EVtivity/evtivity-ev-tester/jlcpcb/ac-tester-bom.csv

Comment | Designator | Footprint | LCSC Part #
2N7002 | Q1,Q2,Q5,Q6,Q7 | SOT-23 | C8545
SMAJ6.0A (6.0V standoff clears the 5.25V rail) | TVS1 | SMA | C10683
silicon signal diode (J1772 CP series) | D1 | SOD-323 | C2128
BAT54WS | D2,D3 | SOD-323 | C22629
TPS26621 60V eFuse OVP+auto-retry | U3 | VSON-10(DRC) | C1848341
390k 1% | R11 | 0603 | C137735
51k 1% | R12 | 0603 | C23196
110k 1% | R13 | 0603 | C25805
10k 1% | R14,R16,R17,R18,R19 | 0603 | C98220
100k 1% | R20,R15,R2,R4,R21 | 0603 | C25803
1uF X7R 50V | C8 | 0603 | C559769
15V bidir TVS | TVS2 | SOD-323 | C720654
PP ESD 3V3 | D6 | SOD-323 | C2687129
PMEG2005AEA very-low-VF 20V Schottky (LCD-5V OR) | D7,D8 | SOD-323 | C179428
2.74k 1% | R1 | 0603 | C22944
1.3k 1% | R3 | 0603 | C22767
220 1% | R10 | 0603 | C22962
33k 1% | R7 | 0603 | C4216
330 1% | R8 | 0603 | C23138
1k 1% | R9 | 0603 | C21190
1nF C0G 50V | C1,C2 | 0603 | C163508
100nF 50V | C4,C6,C7 | 0603 | C14663
10uF 25V | C5,C3 | 0603 | C96446
PTC resettable 1A | F1 | 1812 | C142747
AP2112K-3.3 600mA LDO | U2 | SOT-23-5 | C51118
