EVtivity/evtivity-ev-tester/jlcpcb/ac-tester-3d-full.step

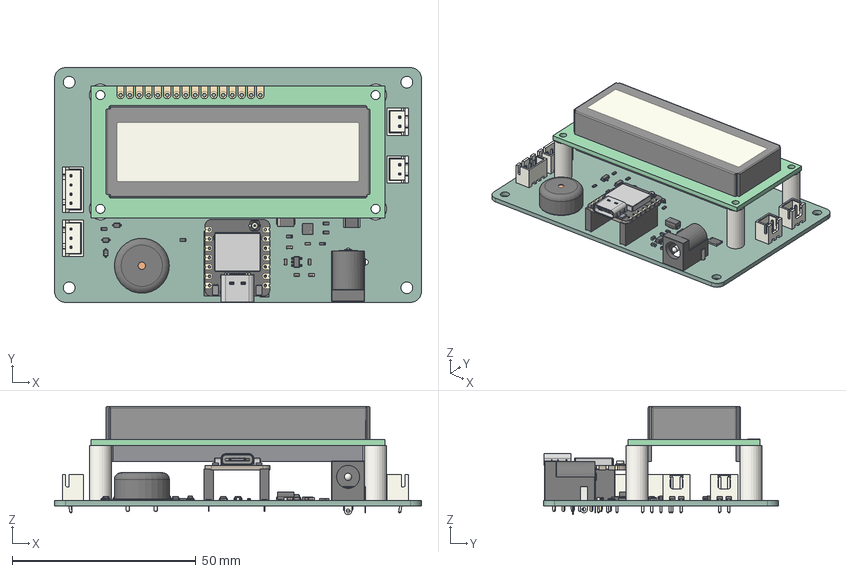
[picture p7: CAD file, 2026-09-27]
jlcpcb/ac-tester-3d-full.step
100.0 x 64.0 x 29.5 mm
JST_B4B_XH_A
VSON_10_1EP_3x3mm_Pitch05mm_ThermalPad
R_0603_1608Metric x 19
PinSocket_1x07_P2.54mm_Vertical x 2
JST_B3B_XH_A
SOT-23 x 5
D_SOD-323 x 7
Pad_001_sp
SOT-23-5
JST_B2B_XH_A x 2
Mounting_Wuerth_WA-SMSI-M3_H15mm_9774150360 x 4
C_0603_1608Metric x 8
Buzzer_15x75RM76
BarrelJack_Horizontal
D_SMA
R_1812_4532Metric
BOSS-EXTRUDE14_8_
BOSS-EXTRUDE7_4_
BOSS-EXTRUDE7_3_
BOSS-EXTRUDE14_4_
BOSS-EXTRUDE14_2_
BOSS-EXTRUDE14_11_
BOSS-EXTRUDE7_7_
BOSS-EXTRUDE14_9_
BOSS-EXTRUDE14_3_
BOSS-EXTRUDE14_7_
MIRROR2
BOSS-EXTRUDE14_5_
BOSS-EXTRUDE14_12_
BOSS-EXTRUDE7_8_
BOSS-EXTRUDE7_1_
BOSS-EXTRUDE14_10_
BOSS-EXTRUDE7_9_
BOSS-EXTRUDE14_6_
BOSS-EXTRUDE14_1_
BOSS-EXTRUDE7_6_
BOSS-EXTRUDE7_2_
CUT-EXTRUDE5
BOSS-EXTRUDE7_5_
Shield
Pins x 2
U.FL-R-SMT-1_10_ v1
ac-tester-step_PCB
