EVtivity/evtivity-ev-tester/enclosure/EV-Tester-case-bottom.stl

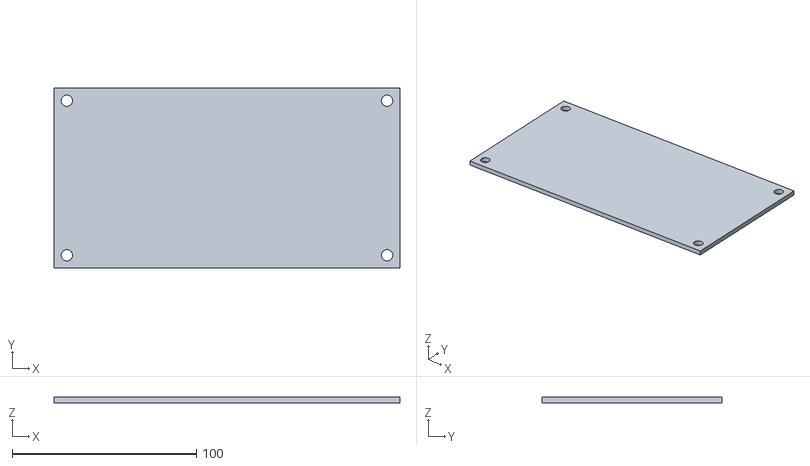
[picture p8: CAD file, 2026-09-27]
enclosure/EV-Tester-case-bottom.stl
188.0 x 98.0 x 3.00
