EVtivity/evtivity-ev-tester/enclosure/EV-Tester-case-top.stl

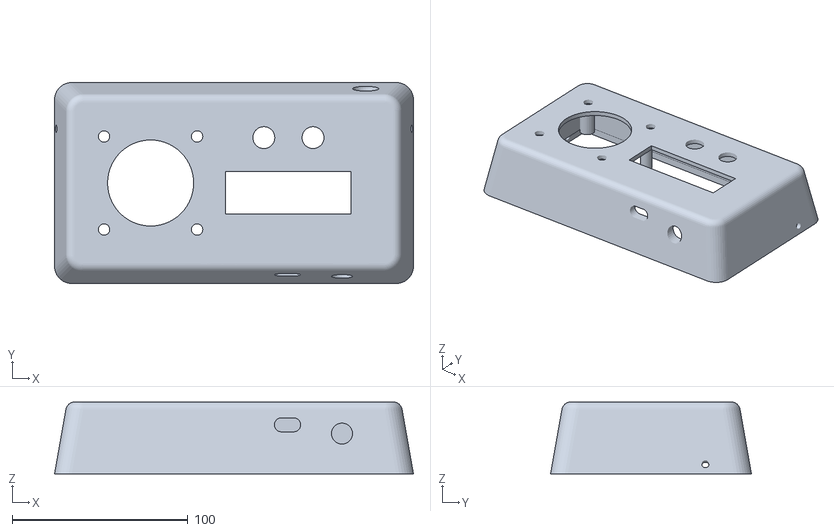
[picture p9: CAD file, 2026-09-27]
enclosure/EV-Tester-case-top.stl
204.5 x 114.5 x 41.0
