EVtivity/evtivity-ev-tester/enclosure/EV-Tester-case-mount.stl

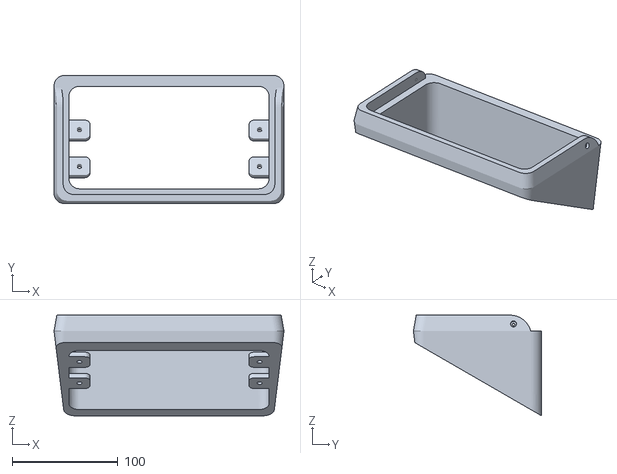
[picture p10: CAD file, 2026-09-27]
enclosure/EV-Tester-case-mount.stl
217.0 x 121.0 x 95.0
