EVtivity/evtivity-ev-tester/jlcpcb/ac-tester-frontal.png

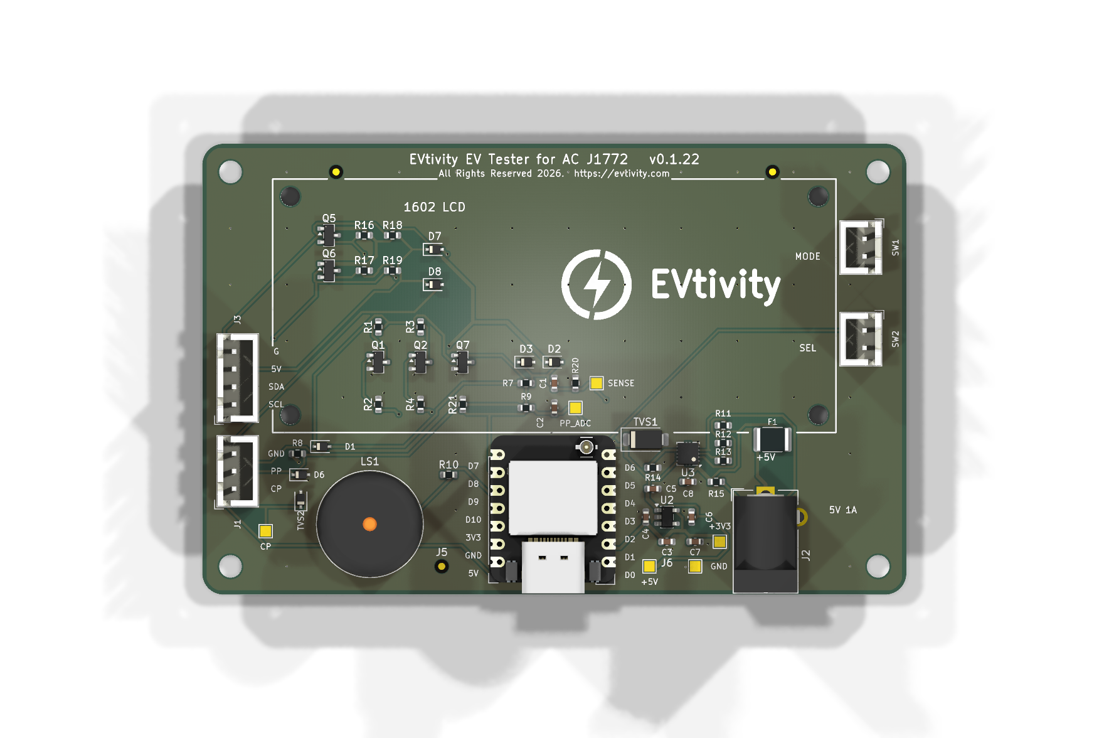
jlcpcb/ac-tester-frontal.png
