EVtivity/evtivity-ev-tester/(commit log)

2026-09-27 Initial open-source release: EVtivity EV Tester (AC J1772) v0.1.22
    [EV-Tester-case-bottom.stl, EV-Tester-case-mount.stl, EV-Tester-case-top.stl, ac-tester-3d-full.step, ac-tester-bom.csv, ac-tester-production.kicad_pcb, ac-tester-production.kicad_sch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]
2026-09-27 Add top-down board render (jlcpcb/ac-tester-frontal.png)
